LucaVLR/Farmlab-XY/README.md

# Farmlab-XY
Repository die alle code bevat voor de realisatie van het XY systeem

Docsify link:
https://lucavlr.github.io/Farmlab-XY/#/
