LucaVLR/Farmlab-XY/src/NodeRED/README.md

Bevat alle NodeRED flows die gebruikt zijn binnen het project

XY_Controller => De flow die gebruikt is om het MQTT dashboard te testen met 2 TMC2209 stepper drivers.
