LucaVLR/Farmlab-XY/src/ESP Software/Arduino/README.md

Bevat de verschillende gebruikte Arduino programma's.

Farmlab_XY_Test1 => Met dit programma is het aansturen van XY systeem door middel van een NodeRED dashboard met MQTT uitgetest.

tmc_test => Met dit programma is de basisfunctie van 1 TMC2009 stepper driver uitgetest.

TMC_NodeRED => Met dit programma is het aansturen van de twee TMC2209 stepper drivers door middel van [een NodeRED dashboard](../NodeRED/XY_Controller.json) met MQTT uitgetest.
