LucaVLR/Farmlab-XY/docs/_sidebar.md

* [Main](/)
* [TMC2209](tmc.md)
* [Kalibratie](kalibratie%20systeem.md)
* [Autoroute](autoroute.md)
* [Camera](camera.md)
* [PCB Design](pcb.md)
* [NodeRED](nodered.md)
