LucaVLR/Farmlab-XY/src/PCB/xy-systeem V1/xy-systeem.kicad_pcb

## KiCad design src/PCB/xy-systeem V1/xy-systeem.kicad_pcb (2022-12-02, an earlier design)

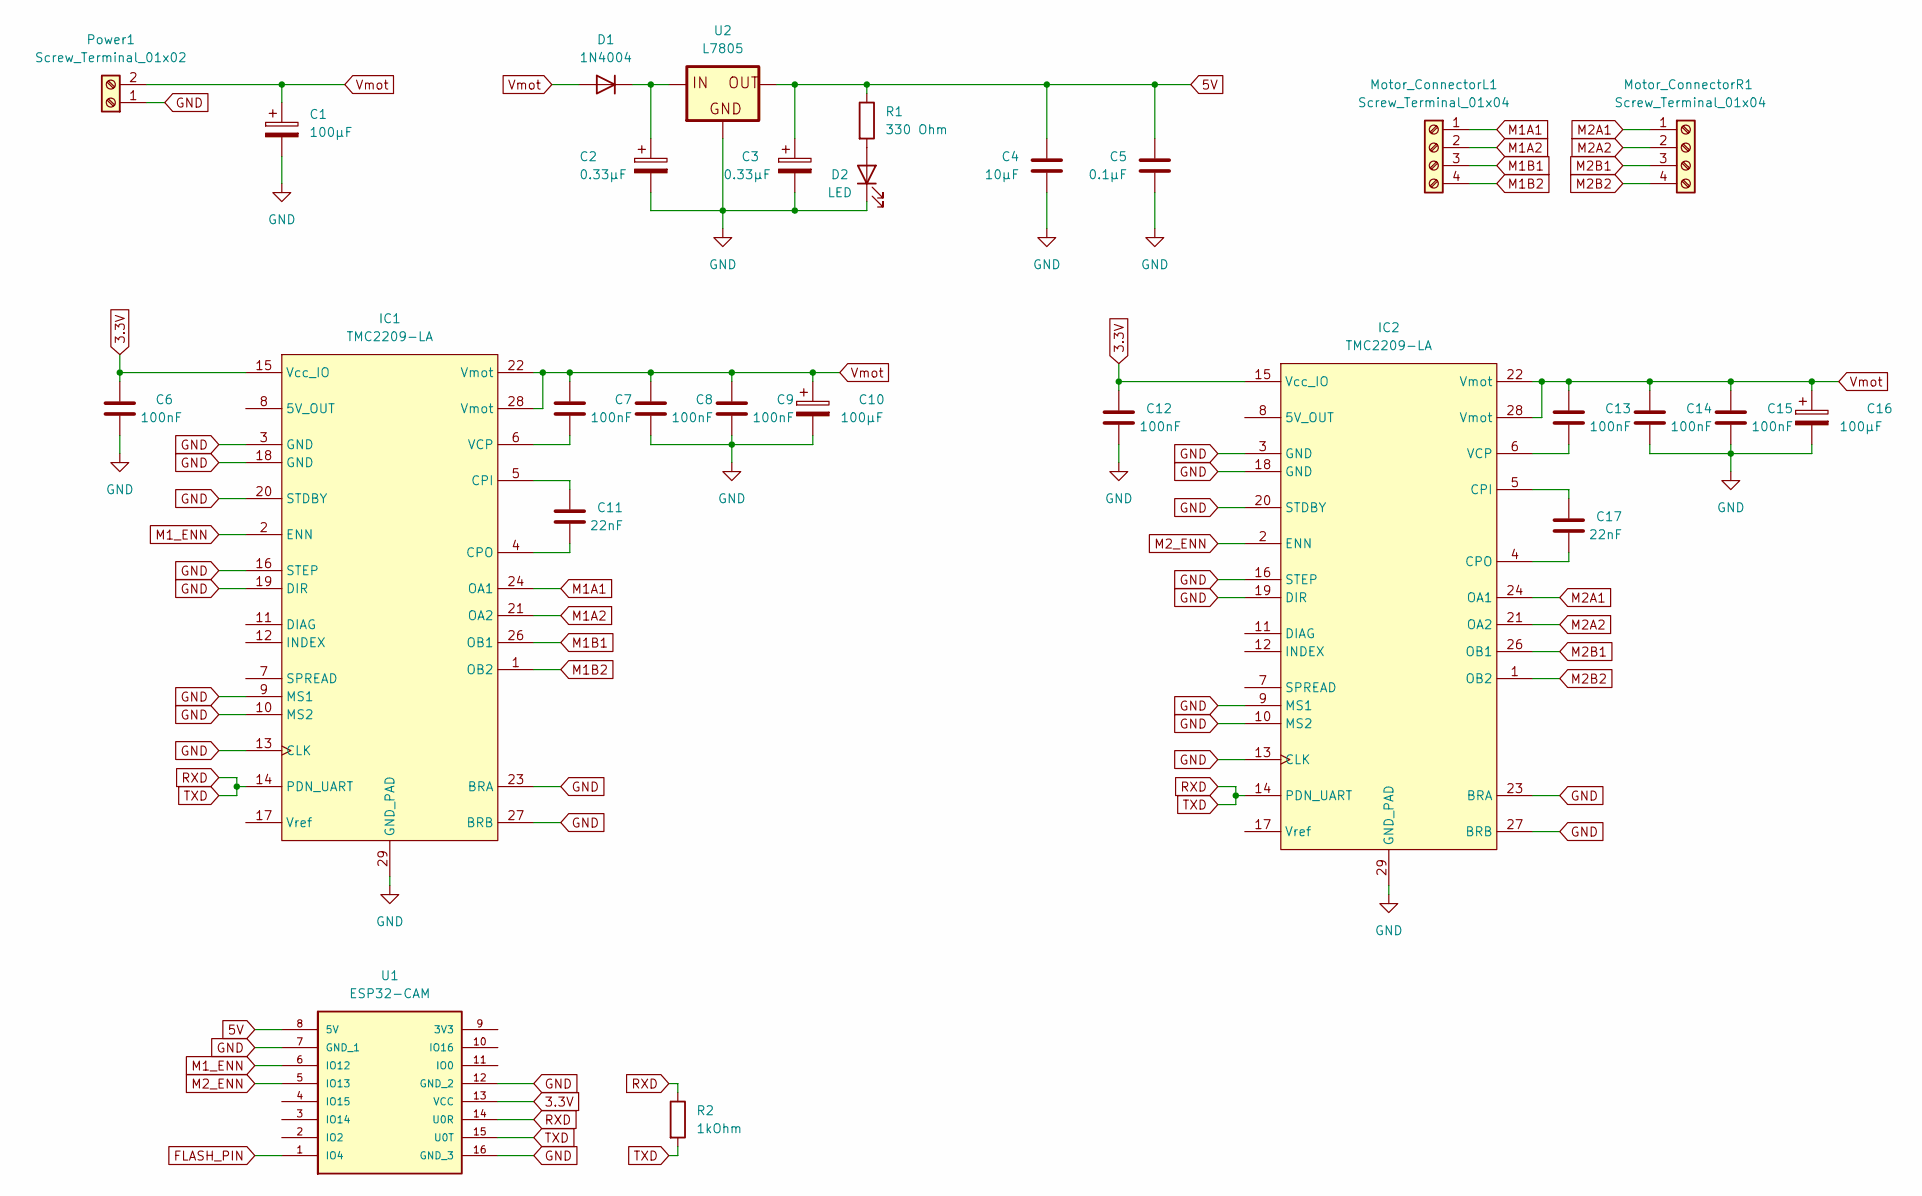
[picture p16: schematic xy-systeem.kicad_sch]

Parts:
C1, C10, C16: 100µF; CP_Radial_D8.0mm_P3.50mm
C2, C3: 0.33µF; C_0805_2012Metric_Pad1.18x1.45mm_HandSolder
C4: 10µF; CP_Radial_D8.0mm_P3.50mm
C5: 0.1µF; C_0805_2012Metric_Pad1.18x1.45mm_HandSolder
C6, C7, C8, C9, C12, C13, C14, C15: 100nF; C_0805_2012Metric_Pad1.18x1.45mm_HandSolder
C11, C17: 22nF; C_0805_2012Metric_Pad1.18x1.45mm_HandSolder
D1: 1N4004; D_DO-41_SOD81_P10.16mm_Horizontal
D2: LED; LED_0805_2012Metric_Pad1.15x1.40mm_HandSolder
IC1, IC2: TMC2209-LA
Motor_ConnectorL1: Screw_Terminal_01x04; TerminalBlock_bornier-4_P5.08mm
Motor_ConnectorR1: Screw_Terminal_01x04; TerminalBlock_bornier-4_P5.08mm
Power1: Screw_Terminal_01x02; TerminalBlock_bornier-2_P5.08mm
R1: 330 Ohm; R_0805_2012Metric_Pad1.20x1.40mm_HandSolder
R2: 1kOhm; R_0805_2012Metric_Pad1.20x1.40mm_HandSolder
U1: ESP32-CAM; MANUFACTURER_PART_NUMBER ESP32-CAM
U2: L7805; 78XXS

Connections:
3.3V: C6.1, C12.1, IC1.15 (Vcc_IO), IC2.15 (Vcc_IO), U1.13 (VCC)
5V: C3.1, C4.1, C5.1, R1.1, U1.8 (5V), U2.OUT
FLASH_PIN: U1.1 (IO4)
GND: C1.2, C2.2, C3.2, C4.2, C5.2, C6.2, C8.2, C9.2, C10.2, C12.2, C14.2, C15.2, C16.2, D2.1 (K), IC1.3 (GND), IC1.9 (MS1), IC1.10 (MS2), IC1.13 (CLK), IC1.16 (STEP), IC1.18 (GND), IC1.19 (DIR), IC1.20 (STDBY), IC1.23 (BRA), IC1.27 (BRB), IC1.29 (GND_PAD), IC2.3 (GND), IC2.9 (MS1), IC2.10 (MS2), IC2.13 (CLK), IC2.16 (STEP), IC2.18 (GND), IC2.19 (DIR), IC2.20 (STDBY), IC2.23 (BRA), IC2.27 (BRB), IC2.29 (GND_PAD), Power1.1, U1.7 (GND_1), U1.12 (GND_2), U1.16 (GND_3), U2.GND
M1A1: IC1.24 (OA1), Motor_ConnectorL1.1; also elsewhere on the board
M1A2: IC1.21 (OA2), Motor_ConnectorL1.2; also elsewhere on the board
M1B1: IC1.26 (OB1), Motor_ConnectorL1.3; also elsewhere on the board
M1B2: IC1.1 (OB2), Motor_ConnectorL1.4; also elsewhere on the board
M1_ENN: IC1.2 (ENN), U1.6 (IO12)
M2A1: IC2.24 (OA1), Motor_ConnectorR1.1; also elsewhere on the board
M2A2: IC2.21 (OA2), Motor_ConnectorR1.2; also elsewhere on the board
M2B1: IC2.26 (OB1), Motor_ConnectorR1.3; also elsewhere on the board
M2B2: IC2.1 (OB2), Motor_ConnectorR1.4; also elsewhere on the board
M2_ENN: IC2.2 (ENN), U1.5 (IO13)
unnamed: C2.1, D1.1 (K), U2.IN
unnamed: C7.2, IC1.6 (VCP)
unnamed: C11.1, IC1.5 (CPI)
unnamed: C11.2, IC1.4 (CPO)
unnamed: C13.2, IC2.6 (VCP)
unnamed: C17.1, IC2.5 (CPI)
unnamed: C17.2, IC2.4 (CPO)
unnamed: D2.2 (A), R1.2
RXD: IC1.14 (PDN_UART), IC2.14 (PDN_UART), R2.1, R2.2, U1.14 (U0R), U1.15 (U0T)
Vmot: C1.1, C7.1, C8.1, C9.1, C10.1, C13.1, C14.1, C15.1, C16.1, D1.2 (A), IC1.22 (Vmot), IC1.28 (Vmot), IC2.22 (Vmot), IC2.28 (Vmot), Power1.2

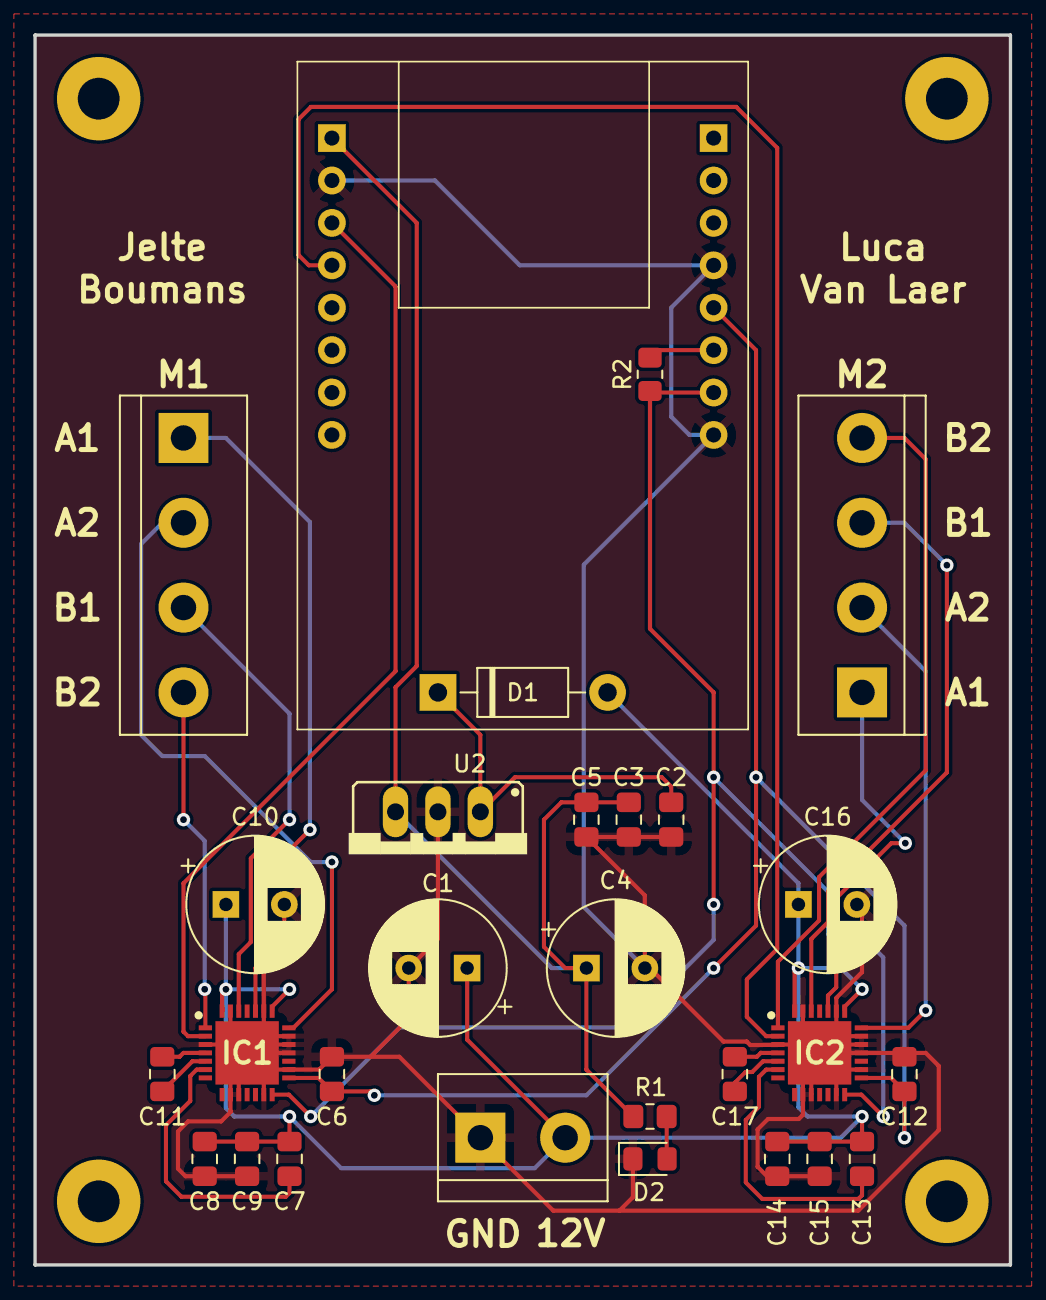
[picture p17: board xy-systeem.kicad_pcb from above]

Board: 2 copper layers, 58.4 x 73.7 mm, 28 parts (0 on the bottom side), 23 nets.

Other parts of the board:
Motor_ConnectorL: Screw_Terminal_01x04; TerminalBlock_bornier-4_P5.08mm
Motor_ConnectorR: Screw_Terminal_01x04; TerminalBlock_bornier-4_P5.08mm

Their connections:
M1A1: Motor_ConnectorL.1; also elsewhere on the board
M1A2: Motor_ConnectorL.2; also elsewhere on the board
M1B1: Motor_ConnectorL.3; also elsewhere on the board
M1B2: Motor_ConnectorL.4; also elsewhere on the board
M2A1: Motor_ConnectorR.1; also elsewhere on the board
M2A2: Motor_ConnectorR.2; also elsewhere on the board
M2B1: Motor_ConnectorR.3; also elsewhere on the board
M2B2: Motor_ConnectorR.4; also elsewhere on the board
