LucaVLR/Farmlab-XY/(commit log)

2022-06-13 Link naar nodered flow toegevoegd
2022-10-07 Fixed green tint issue
    [camera_encode_test.ino]
2022-10-07 fixed brown out issue
    [encoded_image_mqtt_send.ino]
2022-10-07 Update calibratie_foto_demo.ino
    WiFi veranderd
    boot up camera calibratie toegevoegd
2022-10-14 added new nodered flow
2022-10-28 Added QFN soldering pictures
2022-12-02 PCB update - MAIN update
    [xy-systeem-B_Cu.gbl, xy-systeem-B_Mask.gbs, xy-systeem-B_Paste.gbp, xy-systeem-B_Silkscreen.gbo, xy-systeem-Edge_Cuts.gm1, xy-systeem-F_Cu.gtl, xy-systeem-F_Mask.gts, xy-systeem-F_Paste.gtp]
2022-12-02 Crashes + Diff steprate fixed
    [Farmlab_XY_Main_ESPCAM.ino]
2022-12-16 removed velocity multiplier
2022-12-23 Added camera function
